marekw1986/InternetRadioSTM32/hardware/main_board.brd

## EAGLE design hardware/main_board.brd (2020-12-28)

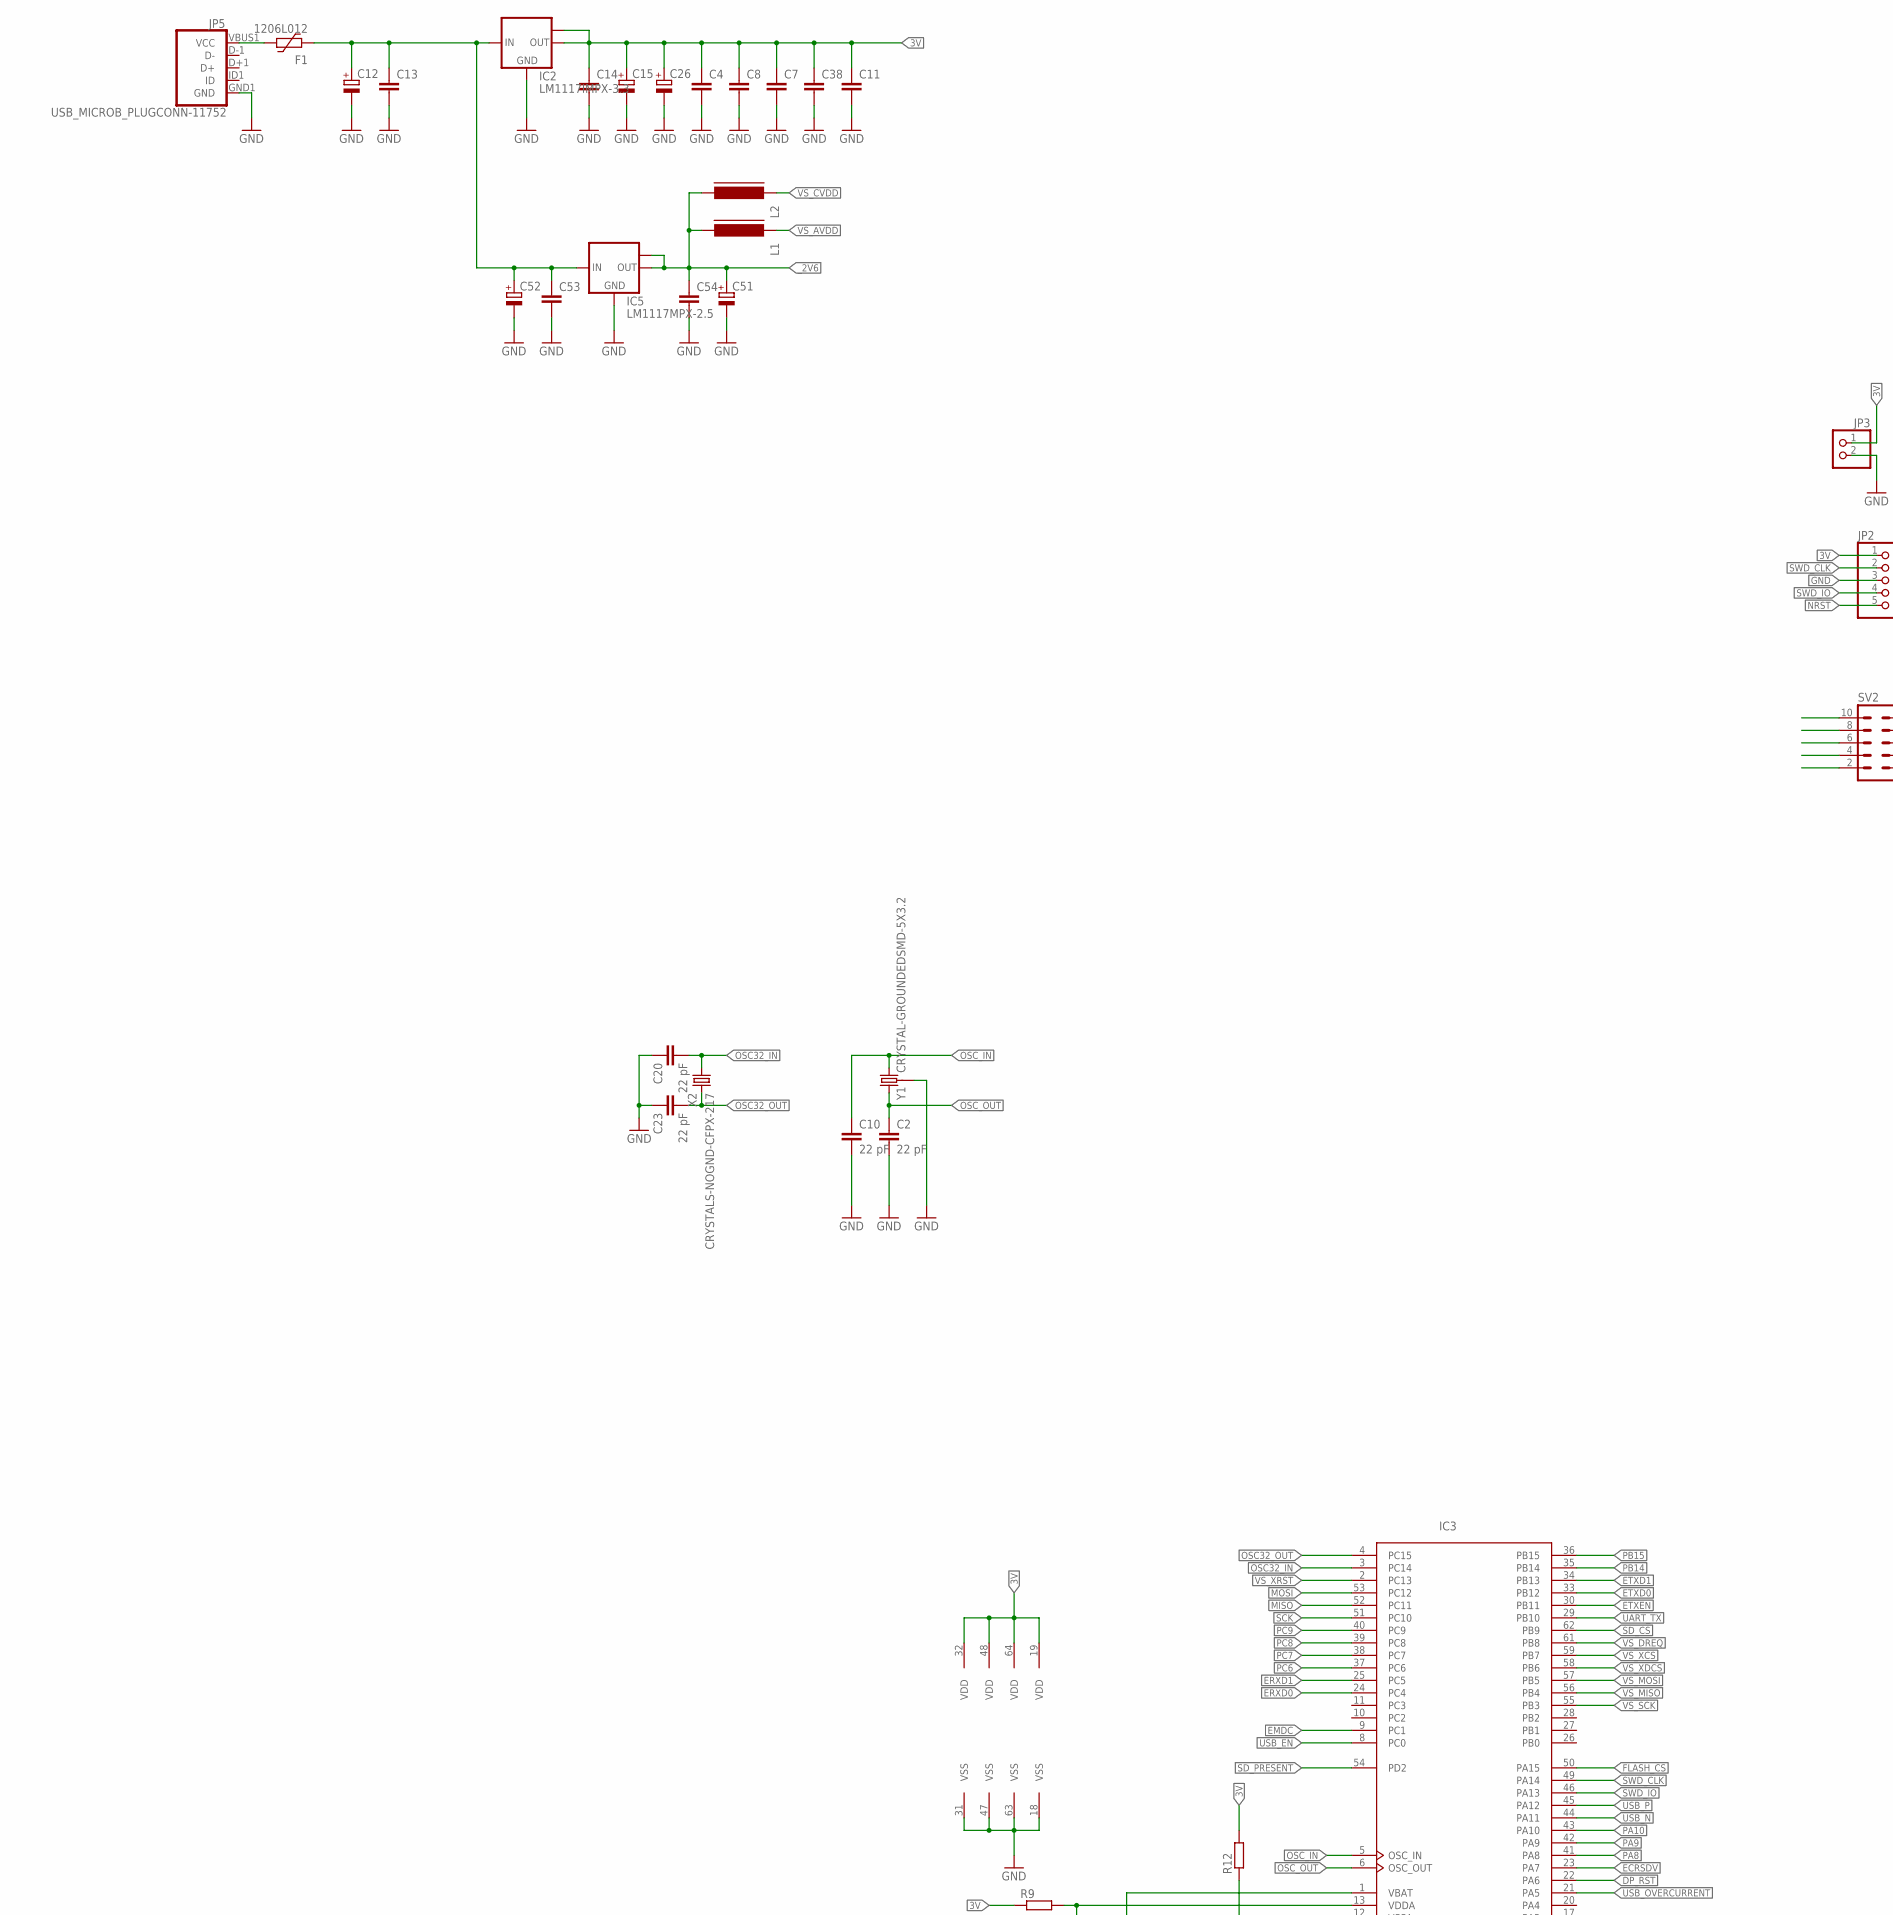
[picture p1: schematic main_board.sch, part in row 1, column 1]

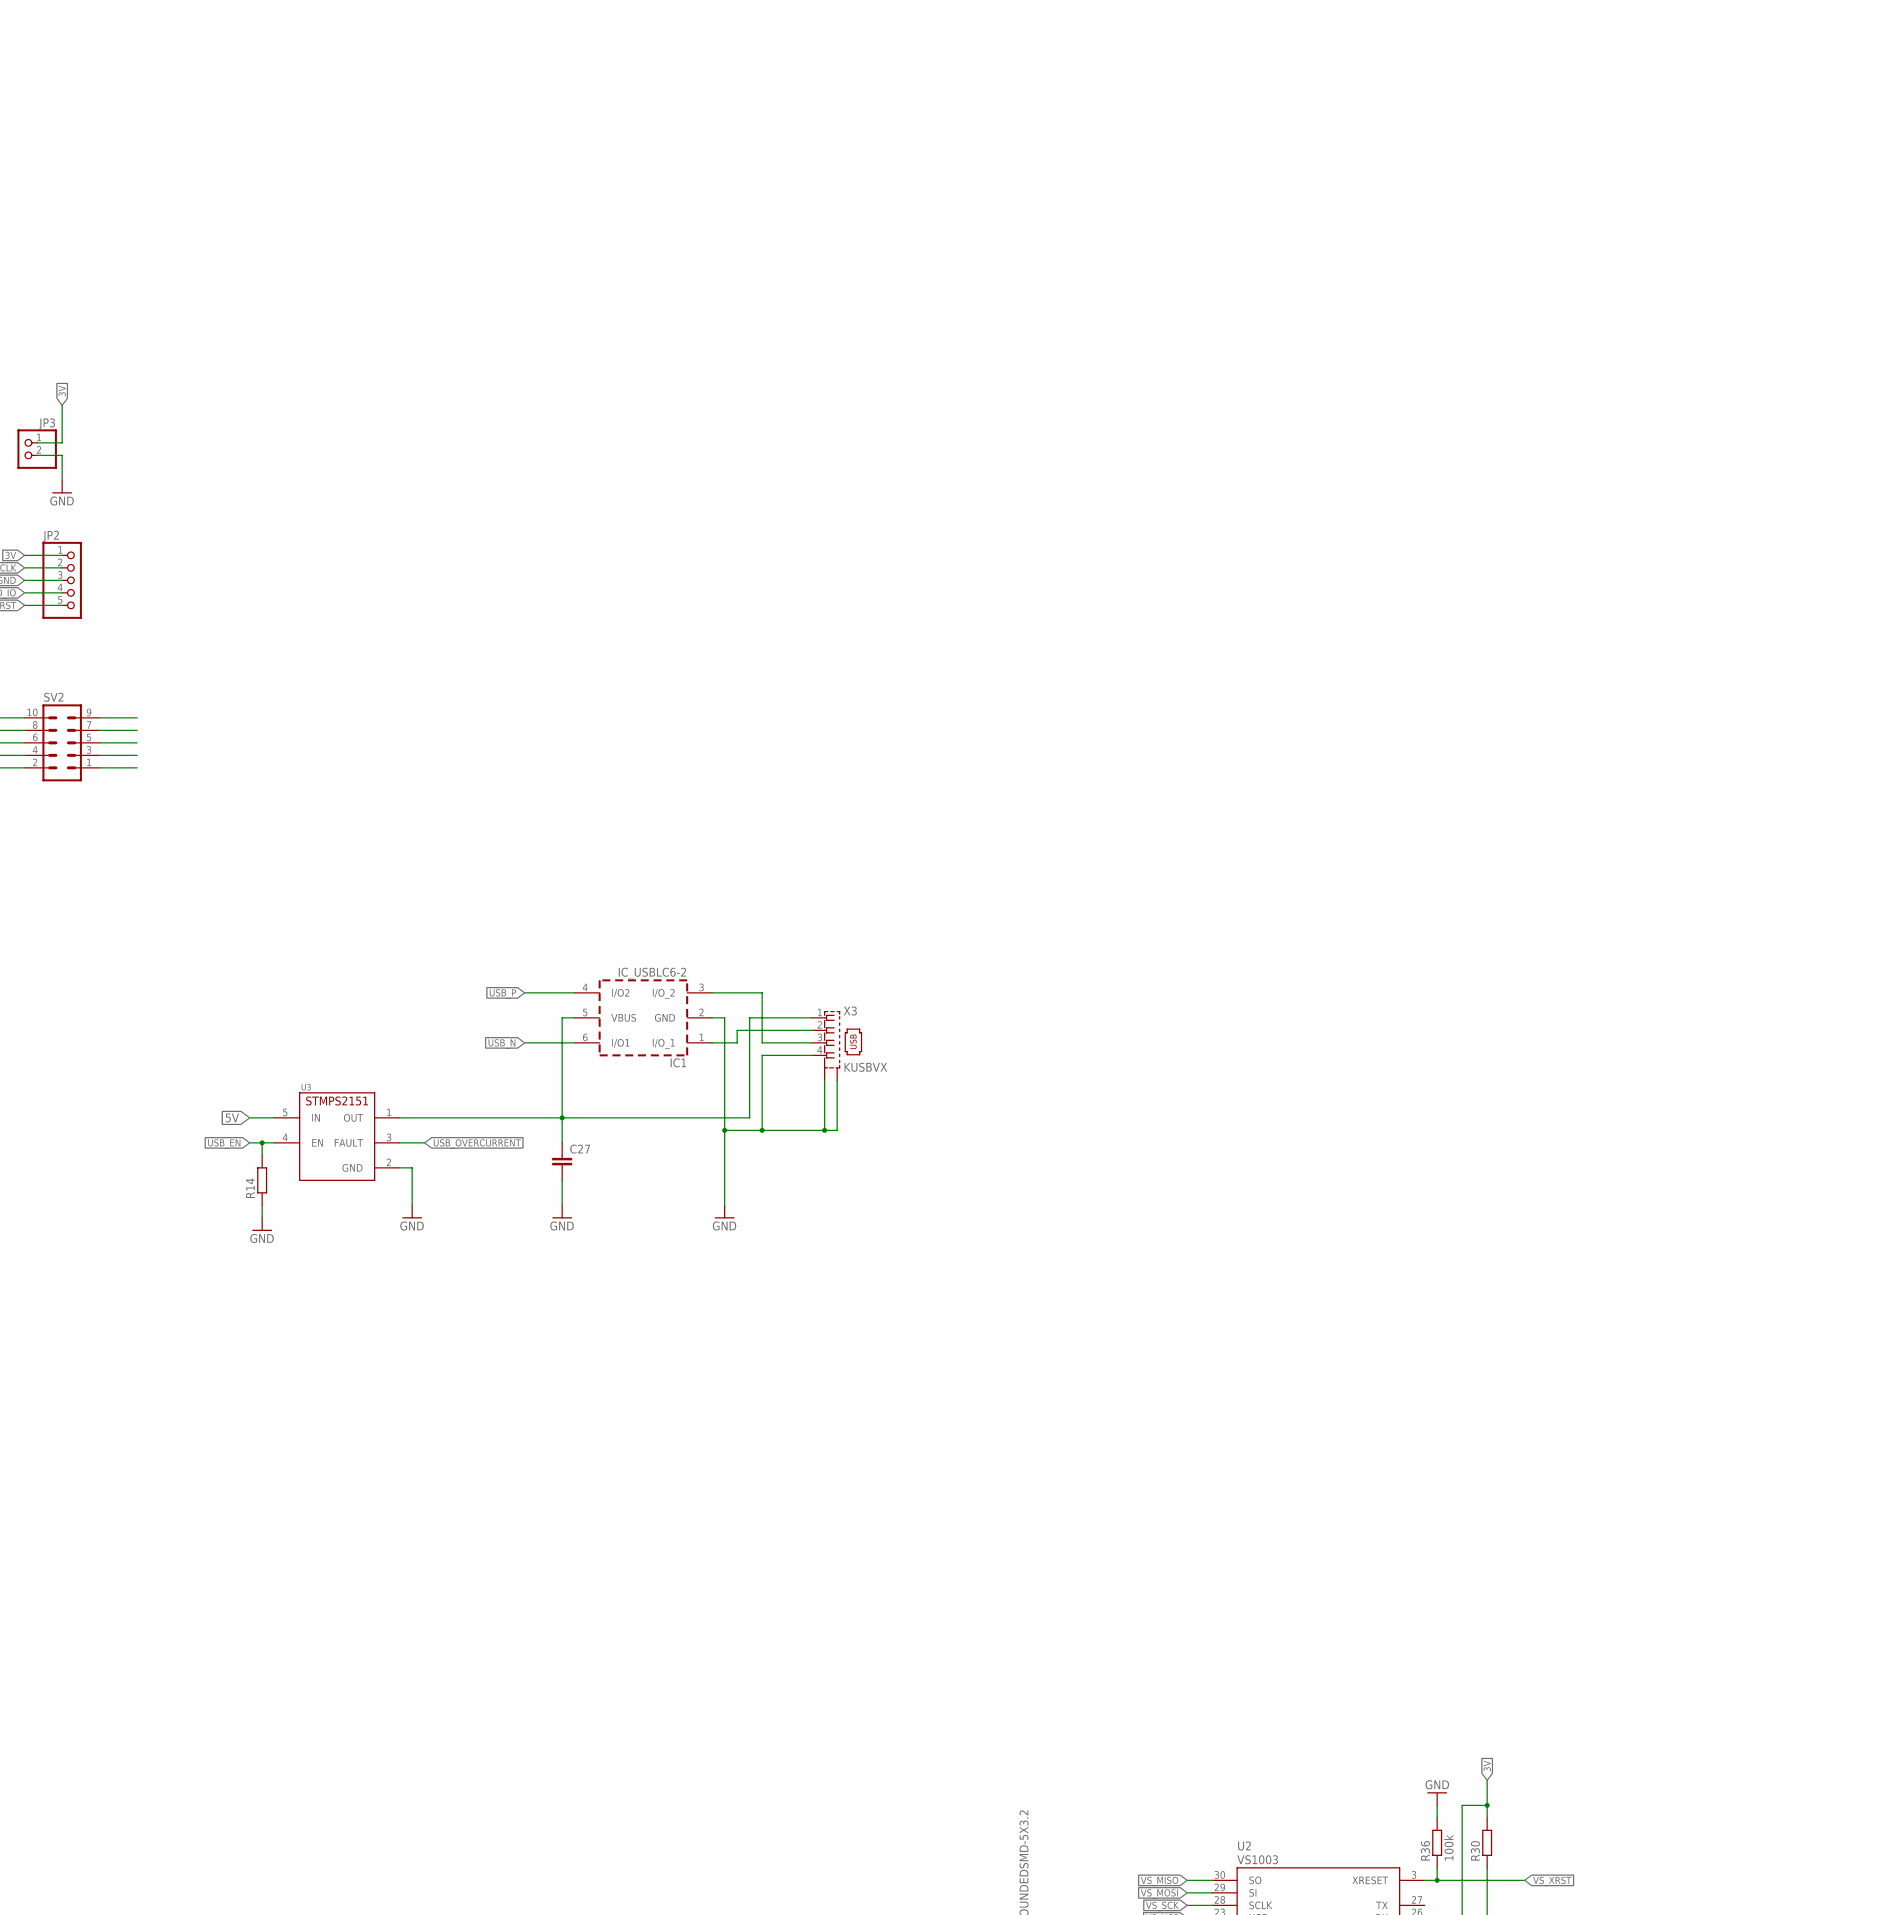
[picture p2: schematic main_board.sch, part in row 1, column 2]

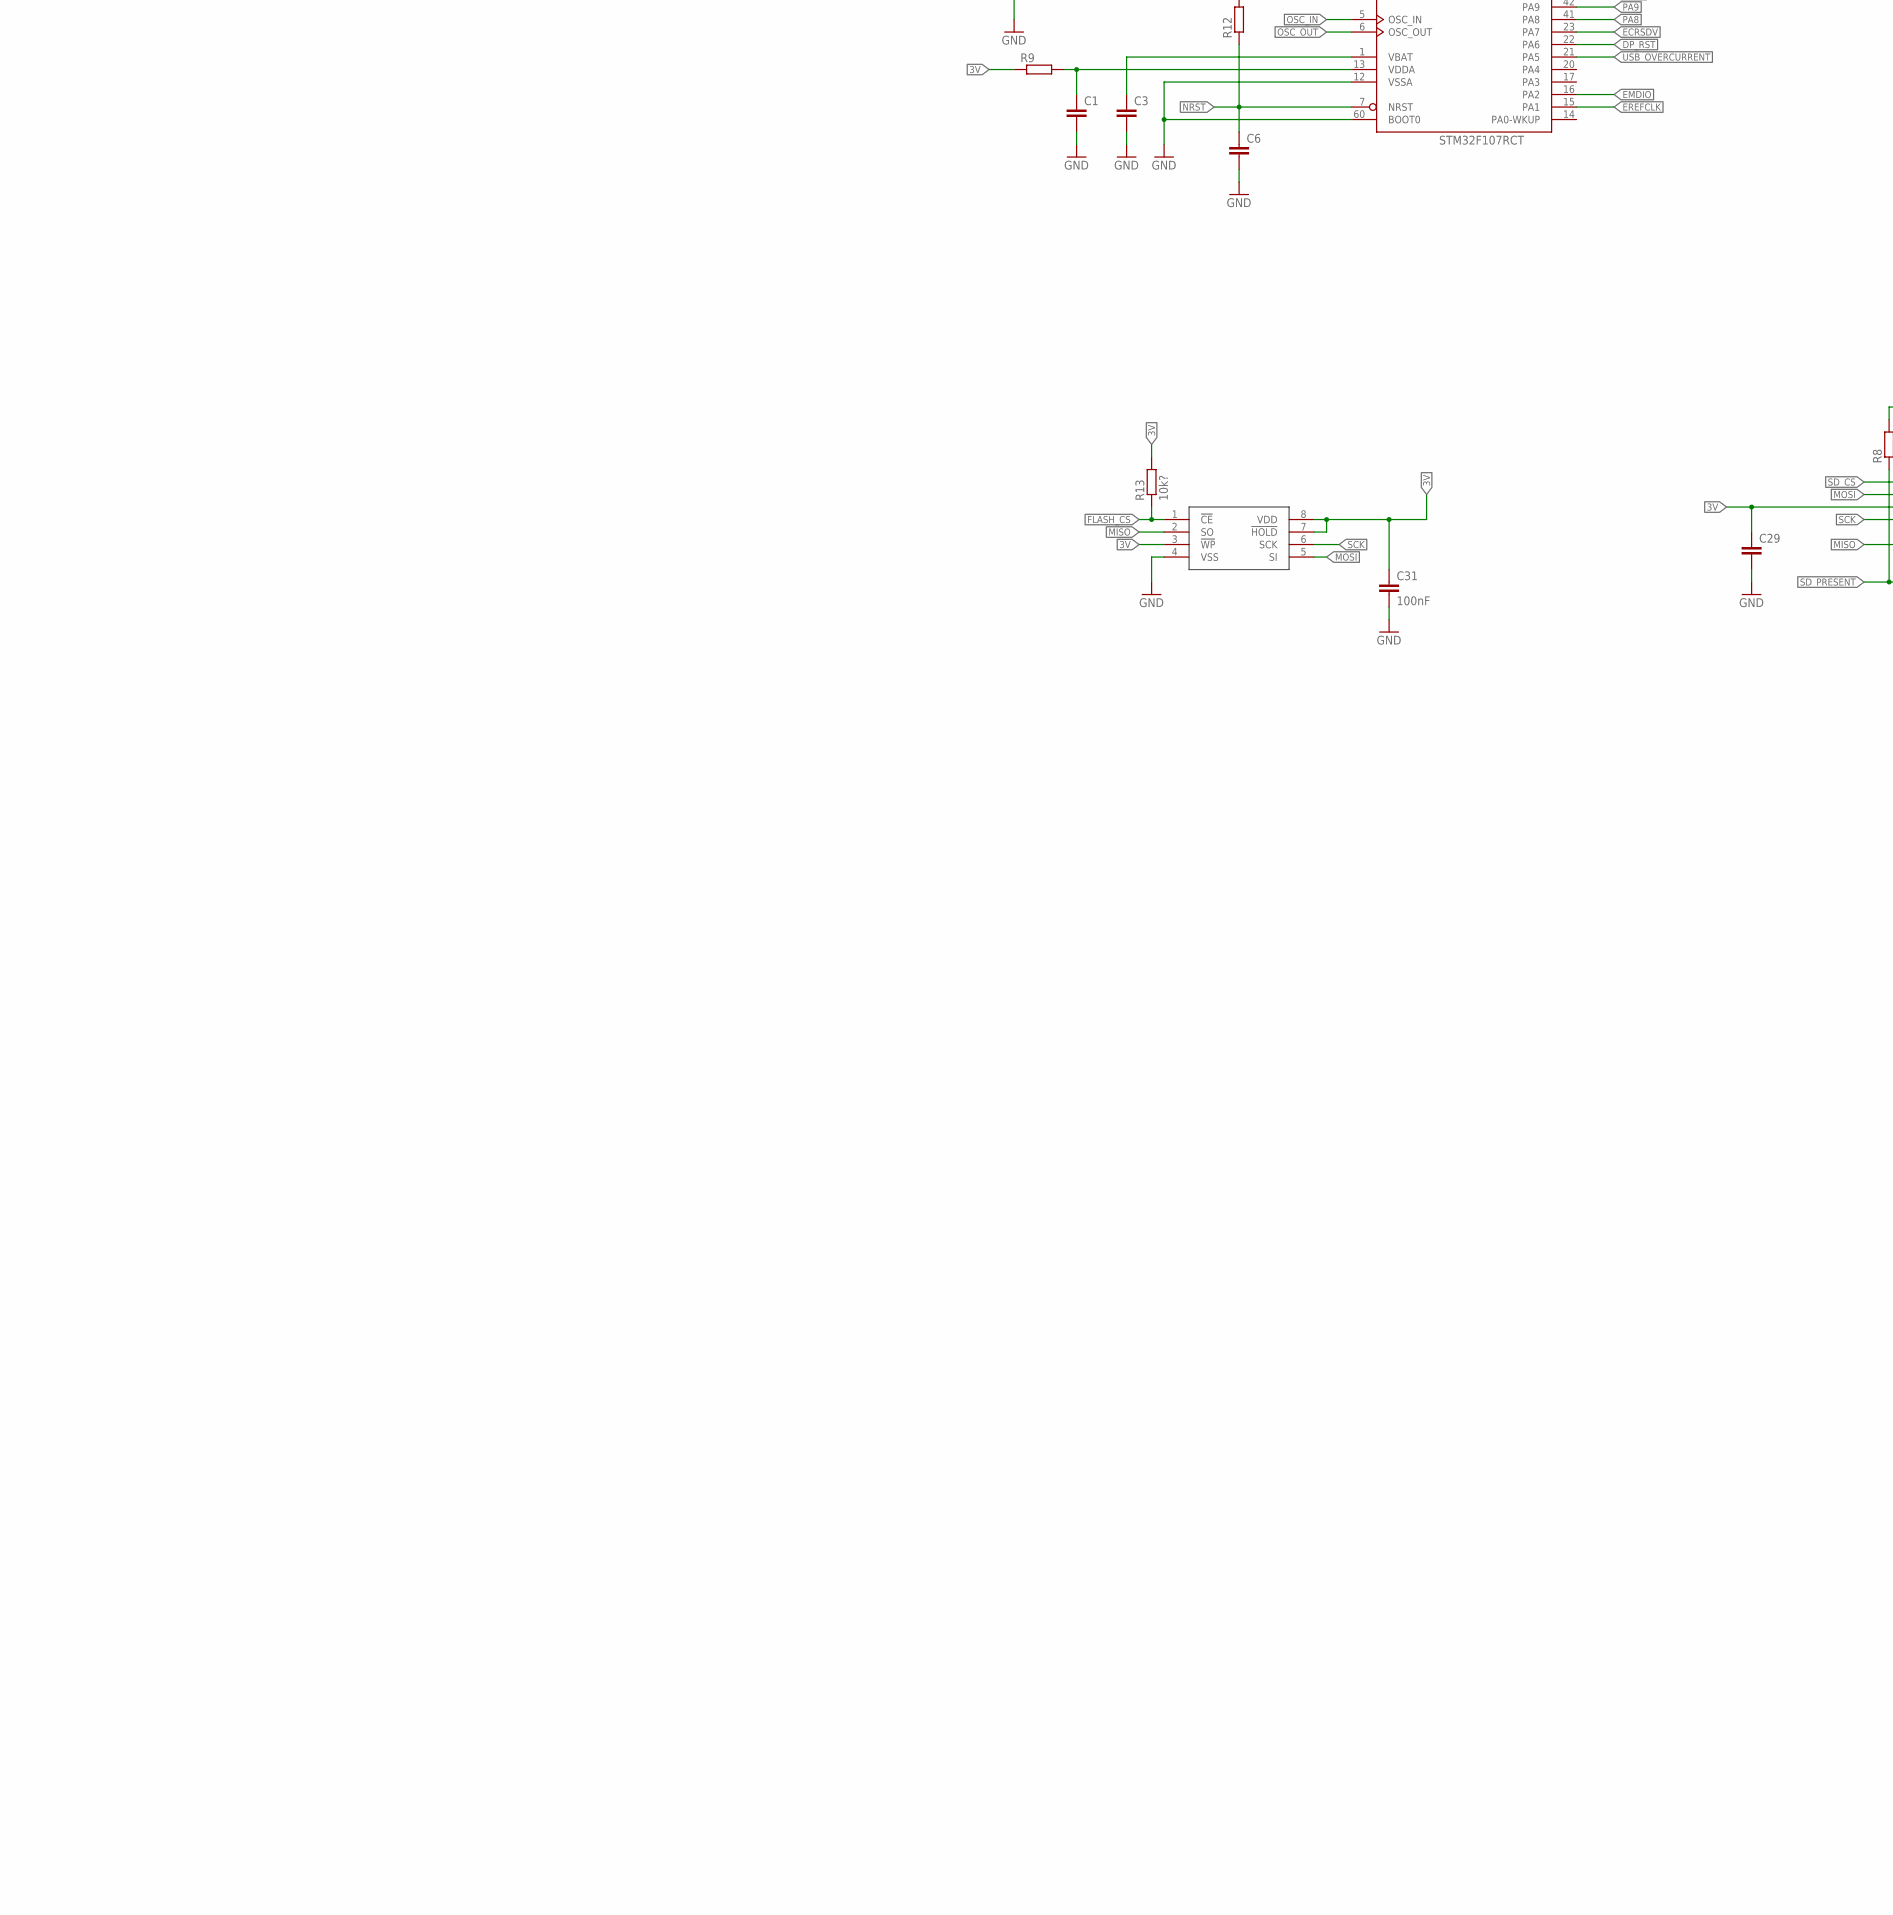
[picture p3: schematic main_board.sch, part in row 2, column 1]

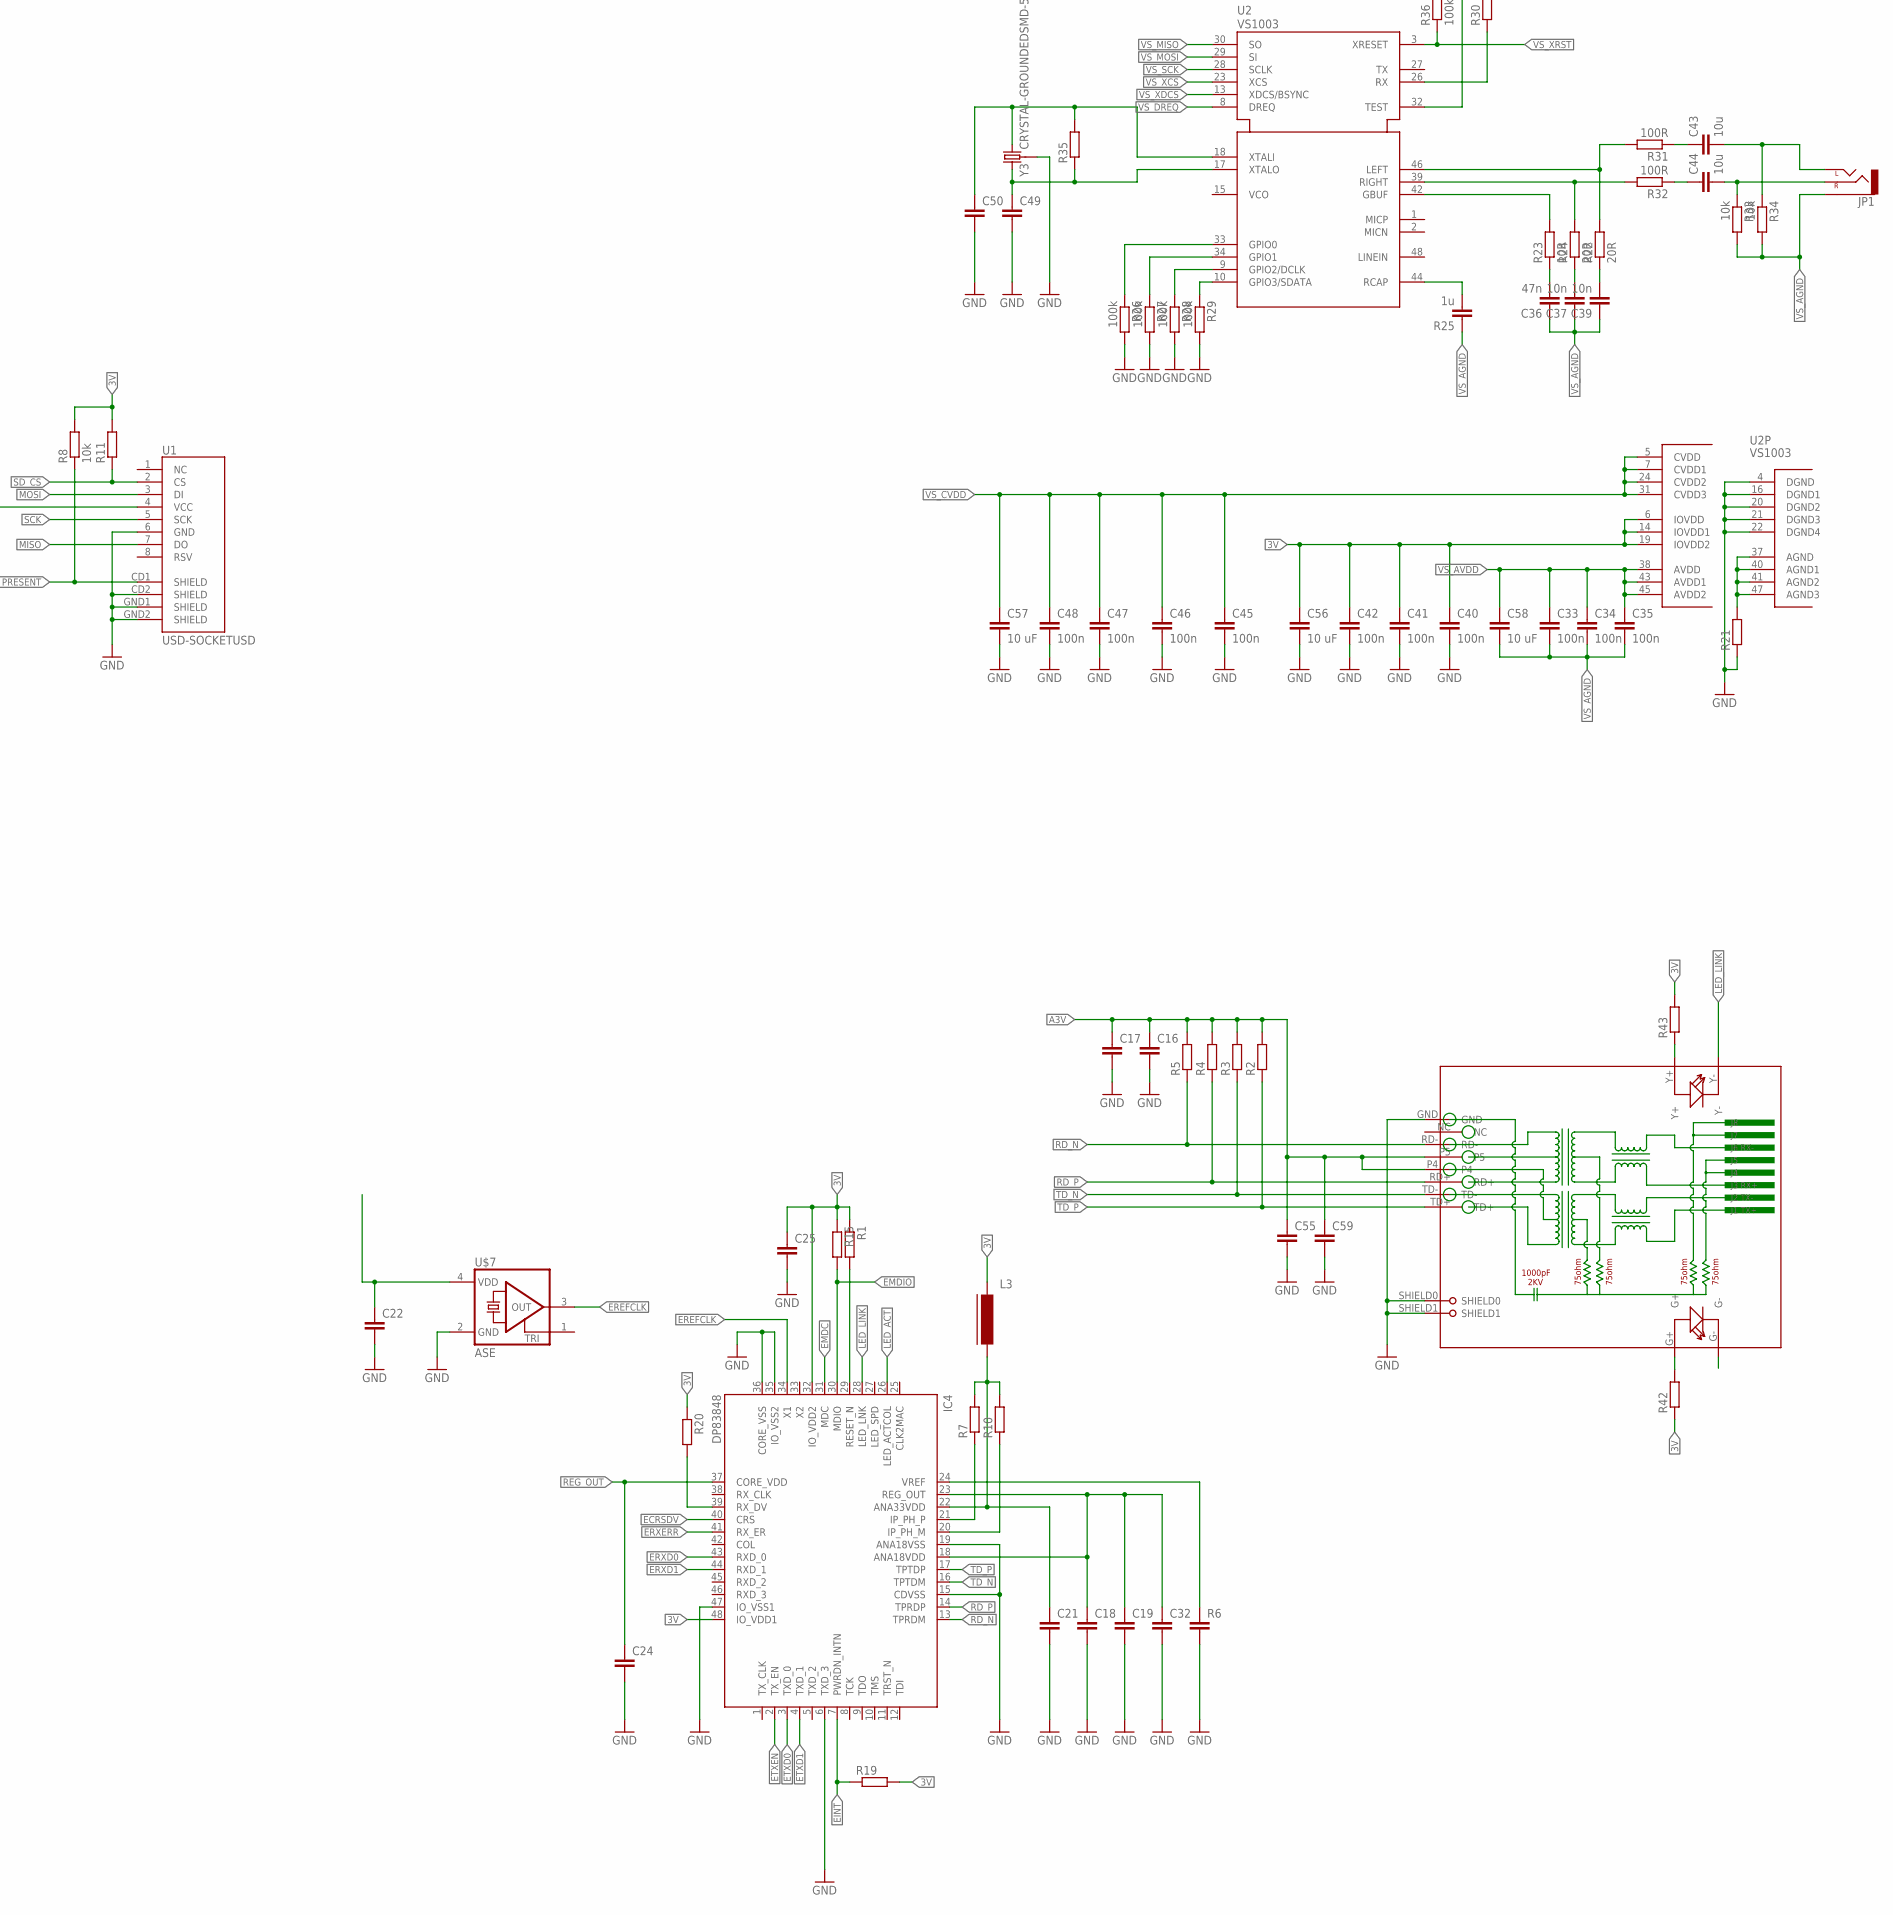
[picture p4: schematic main_board.sch, part in row 2, column 2]

Parts:
C1, C3, C4, C7, C8, C11, C18, C19, C21, C22, C38: C-EUC0402; C0402
C2, C10, C20, C23: 22 pF; C0603
C6, C13, C14, C16, C17, C24, C25, C27, C29, C32, C49, C50, C55, C59: C-EUC0603; C0603
C12, C15, C51, C52: CPOL-EUSMCB; SMC_B
C26: CPOL-EUSMCA; SMC_A
C31: 100nF; C0603
C33, C34, C35, C46, C47, C48: 100n; C0603
C36: 47n; C0603
C37, C39: 10n; C0603
C40, C41, C42, C45: 100n; C0402
C43, C44: 10u; C0603
C53, C54: C-EUC1206; C1206
C56, C57, C58: 10 uF; C0603
F1: 1206L012; 1206L
IC1: IC_USBLC6-2; SOT-23-6L
IC2: LM1117IMPX-3.3; SOT223
IC3: STM32F107RCT; LQFP64
IC4: DP83848; LQFP48
IC5: LM1117MPX-2.5; SOT223
JP1: AUDIO-JACKAUDIO_JACK2; AUDIO-JACK2
JP2: PINHD-1X5; 1X05
JP3: PINHD-1X2/90; 1X02/90
JP5: USB_MICROB_PLUGCONN-11752; USB-B-MICRO-SMD_V03
L1, L2, L3: FERRITE-0805; FB805
R1, R7, R10, R19: R-EU_R0402; R0402
R2, R3, R4, R5, R11, R12, R14, R15, R20, R21, R35, R42, R43: R-EU_R0603; R0603
R6: C-EUC0603; C0603
R8, R33, R34: 10k; R0603
R9: R-EU_M0805; M0805
R13: 10k?; R0603
R22, R24: 20R; R0603
R23: 10R; R0603
R25: 1u; C0603
R26, R27, R28, R29: 100k; R0402
R30: R-EU_0204/7; 0204/7
R31, R32: 100R; R0603
R36: 100k; R0603
RJ1: HR911105A
SV2: ML10L
U1: USD-SOCKETUSD; USD-SOCKET-PP
U2: VS1003; LQFP48
U3: STMPS2151STR; SOT-23-5L
U$2: SST25VF016BSO8M; SO-08M
U$7: ASE
X2: CRYSTALS-NOGND-CFPX-217; 3.2X1.5-2-PAD
X3: KUSBVX
Y1, Y3: CRYSTAL-GROUNDEDSMD-5X3.2; CRYSTAL-SMD-5X3.2-4PAD

Connections:
3V: C4.1, C7.1, C8.1, C11.1, C14.1, C15.+, C22.1, C25.1, C26.+, C29.1, C31.1, C38.1, C40.1, C41.1, C42.1, C56.1, IC2.2 (OUT), IC2.TAB (OUT1), IC3.19 (VDD), IC3.32 (VDD), IC3.48 (VDD), IC3.64 (VDD), IC4.32 (IO_VDD2), IC4.48 (IO_VDD1), JP2.1, JP3.1, L3.1, R1.1, R8.2, R9.1, R11.2, R12.2, R13.2, R15.1, R19.2, R20.1, R30.2, R42.1, R43.2, U1.4 (VCC), U2.6 (IOVDD), U2.14 (IOVDD1), U2.19 (IOVDD2), U2.32 (TEST), U$2.3 (!WP), U$2.7 (!HOLD), U$2.8 (VDD), U$7.4 (VDD)
5V: C12.+, C13.1, C52.+, C53.1, F1.2, IC2.3 (IN), IC5.3 (IN), U3.5 (IN)
A3V: C16.1, C17.1, C21.1, C55.1, C59.1, IC4.22 (ANA33VDD), L3.2, R2.2, R3.2, R4.2, R5.2, R7.2, R10.2, RJ1.P4, RJ1.P5
D2_N: IC1.1 (I/O_1), X3.2
D2_P: IC1.3 (I/O_2), X3.3
DP_RST: IC3.22 (PA6), IC4.29 (RESET_N), R1.2
ECRSDV: IC3.23 (PA7), IC4.40 (CRS)
EINT: IC4.7 (PWRDN_INTN), R19.1
EMDC: IC3.9 (PC1), IC4.31 (MDC)
EMDIO: IC3.16 (PA2), IC4.30 (MDIO), R15.2
EREFCLK: IC3.15 (PA1), IC4.34 (X1), U$7.3 (OUT)
ERXD0: IC3.24 (PC4), IC4.43 (RXD_0)
ERXD1: IC3.25 (PC5), IC4.44 (RXD_1)
ERXERR: IC4.41 (RX_ER)
ETXD0: IC3.33 (PB12), IC4.3 (TXD_0)
ETXD1: IC3.34 (PB13), IC4.4 (TXD_1)
ETXEN: IC3.30 (PB11), IC4.2 (TX_EN)
FLASH_CS: IC3.50 (PA15), R13.1, U$2.1 (!CE)
GND: C1.2, C2.2, C3.2, C4.2, C6.2, C7.2, C8.2, C10.2, C11.2, C12.-, C13.2, C14.2, C15.-, C16.2, C17.2, C18.2, C19.2, C20.1, C21.2, C22.2, C23.1, C24.2, C25.2, C26.-, C27.2, C29.2, C31.2, C32.2, C38.2, C40.2, C41.2, C42.2, C45.2, C46.2, C47.2, C48.2, C49.2, C50.2, C51.-, C52.-, C53.2, C54.2, C55.2, C56.2, C57.2, C59.2, IC1.2 (GND), IC2.1 (GND), IC3.12 (VSSA), IC3.18 (VSS), IC3.31 (VSS), IC3.47 (VSS), IC3.60 (BOOT0), IC3.63 (VSS), IC4.6 (TXD_3), IC4.15 (CDVSS), IC4.19 (ANA18VSS), IC4.35 (IO_VSS2), IC4.36 (CORE_VSS), IC4.47 (IO_VSS1), IC5.1 (GND), JP2.3, JP3.2, JP5.GND1 (GND), R6.2, R14.1, R21.1, R26.2, R27.2, R28.2, R29.2, R36.2, RJ1.GND, RJ1.SHIELD0, RJ1.SHIELD1, U1.6 (GND), U1.CD2 (SHIELD), U1.GND1 (SHIELD), U1.GND2 (SHIELD), U2.4 (DGND), U2.16 (DGND1), U2.20 (DGND2), U2.21 (DGND3), U2.22 (DGND4), U3.2 (GND), U$2.4 (VSS), U$7.2 (GND), X3.4, X3.M1 (S1), X3.M2 (S2), Y1.2 (3), Y1.4 (3), Y3.2 (3), Y3.4 (3)
LED_ACT: IC4.26 (LED_ACTCOL), RJ1.G-
LED_LINK: IC4.28 (LED_LNK), RJ1.Y-
MISO: IC3.52 (PC11), U1.7 (DO), U$2.2 (SO)
MOSI: IC3.53 (PC12), U1.3 (DI), U$2.5 (SI)
unnamed: IC4.21 (IP_PH_P), R7.1
unnamed: C3.1, IC3.1 (VBAT)
unnamed: IC4.24 (VREF), R6.1
unnamed: IC4.20 (IP_PH_M), R10.1
unnamed: R42.2, RJ1.G+
unnamed: F1.1, JP5.VBUS1 (VCC)
unnamed: C36.2, R23.1
unnamed: R43.1, RJ1.Y+
unnamed: C1.1, IC3.13 (VDDA), R9.2
NRST: C6.1, IC3.7 (NRST), JP2.5, R12.1
OSC32_IN: C20.2, IC3.3 (PC14), X2.1
OSC32_OUT: C23.2, IC3.4 (PC15), X2.2
OSC_IN: C10.1, IC3.5 (OSC_IN), Y1.1 (2)
OSC_OUT: C2.1, IC3.6 (OSC_OUT), Y1.3 (1)
PA8: IC3.41 (PA8), SV2.8
PA9: IC3.42 (PA9), SV2.9
PA10: IC3.43 (PA10), SV2.10
PB14: IC3.35 (PB14), SV2.2
PB15: IC3.36 (PB15), SV2.3
PC6: IC3.37 (PC6), SV2.4
PC7: IC3.38 (PC7), SV2.5
PC8: IC3.39 (PC8), SV2.6
PC9: IC3.40 (PC9), SV2.7
RD_N: IC4.13 (TPRDM), R5.1, RJ1.RD-
RD_P: IC4.14 (TPRDP), R4.1, RJ1.RD+
REG_OUT: C18.1, C19.1, C24.1, C32.1, IC4.18 (ANA18VDD), IC4.23 (REG_OUT), IC4.37 (CORE_VDD)
RX_DV: IC4.39 (RX_DV), R20.2
SCK: IC3.51 (PC10), U1.5 (SCK), U$2.6 (SCK)
SD_CS: IC3.62 (PB9), R11.1, U1.2 (CS)
SD_PRESENT: IC3.54 (PD2), R8.1, U1.CD1 (SHIELD)
SWD_CLK: IC3.49 (PA14), JP2.2
SWD_IO: IC3.46 (PA13), JP2.4
TD_N: IC4.16 (TPTDM), R3.1, RJ1.TD-
TD_P: IC4.17 (TPTDP), R2.1, RJ1.TD+
UART_TX: IC3.29 (PB10), SV2.1
USB_EN: IC3.8 (PC0), R14.2, U3.4 (EN)
USB_N: IC1.6 (I/O1), IC3.44 (PA11)
USB_OVERCURRENT: IC3.21 (PA5), U3.3 (FAULT)
USB_P: IC1.4 (I/O2), IC3.45 (PA12)
VBUS: C27.1, IC1.5 (VBUS), U3.1 (OUT), X3.1
VS_AGND: C33.2, C34.2, C35.2, C36.1, C37.1, C39.1, C58.2, JP1.SLEEVE, R21.2, R25.1, R33.2, R34.2, U2.37 (AGND), U2.40 (AGND1), U2.41 (AGND2), U2.47 (AGND3)
VS_AVDD: C33.1, C34.1, C35.1, C58.1, L1.1, U2.38 (AVDD), U2.43 (AVDD1), U2.45 (AVDD2)
VS_CVDD: C45.1, C46.1, C47.1, C48.1, C57.1, L2.1, U2.5 (CVDD), U2.7 (CVDD1), U2.24 (CVDD2), U2.31 (CVDD3)
VS_DREQ: IC3.61 (PB8), U2.8 (DREQ)
VS_MISO: IC3.56 (PB4), U2.30 (SO)
VS_MOSI: IC3.57 (PB5), U2.29 (SI)
VS_N$9: C50.1, R35.2, U2.18 (XTALI), Y3.1 (2)
VS_N$13: C49.1, R35.1, U2.17 (XTALO), Y3.3 (1)
VS_N$14: R22.2, R31.2, U2.46 (LEFT)
VS_N$15: R23.2, U2.42 (GBUF)
VS_N$16: R24.2, R32.2, U2.39 (RIGHT)
VS_N$17: R25.2, U2.44 (RCAP)
VS_N$24: C37.2, R24.1
VS_N$25: C39.2, R22.1
VS_N$26: R29.1, U2.10 (GPIO3/SDATA)
VS_N$27: R28.1, U2.9 (GPIO2/DCLK)
VS_N$28: R27.1, U2.34 (GPIO1)
VS_N$30: R26.1, U2.33 (GPIO0)
VS_N$34: R30.1, U2.26 (RX)
VS_N$35: C43.1, R31.1
VS_N$36: C44.1, R32.1
VS_N$37: C44.2, JP1.RING (RIGHT), R33.1
VS_N$38: C43.2, JP1.TIP (LEFT), R34.1
VS_SCK: IC3.55 (PB3), U2.28 (SCLK)
VS_XCS: IC3.59 (PB7), U2.23 (XCS)
VS_XDCS: IC3.58 (PB6), U2.13 (XDCS/BSYNC)
VS_XRST: IC3.2 (PC13), R36.1, U2.3 (XRESET)
_2V6: C51.+, C54.1, IC5.2 (OUT), IC5.TAB (OUT1), L1.2, L2.2

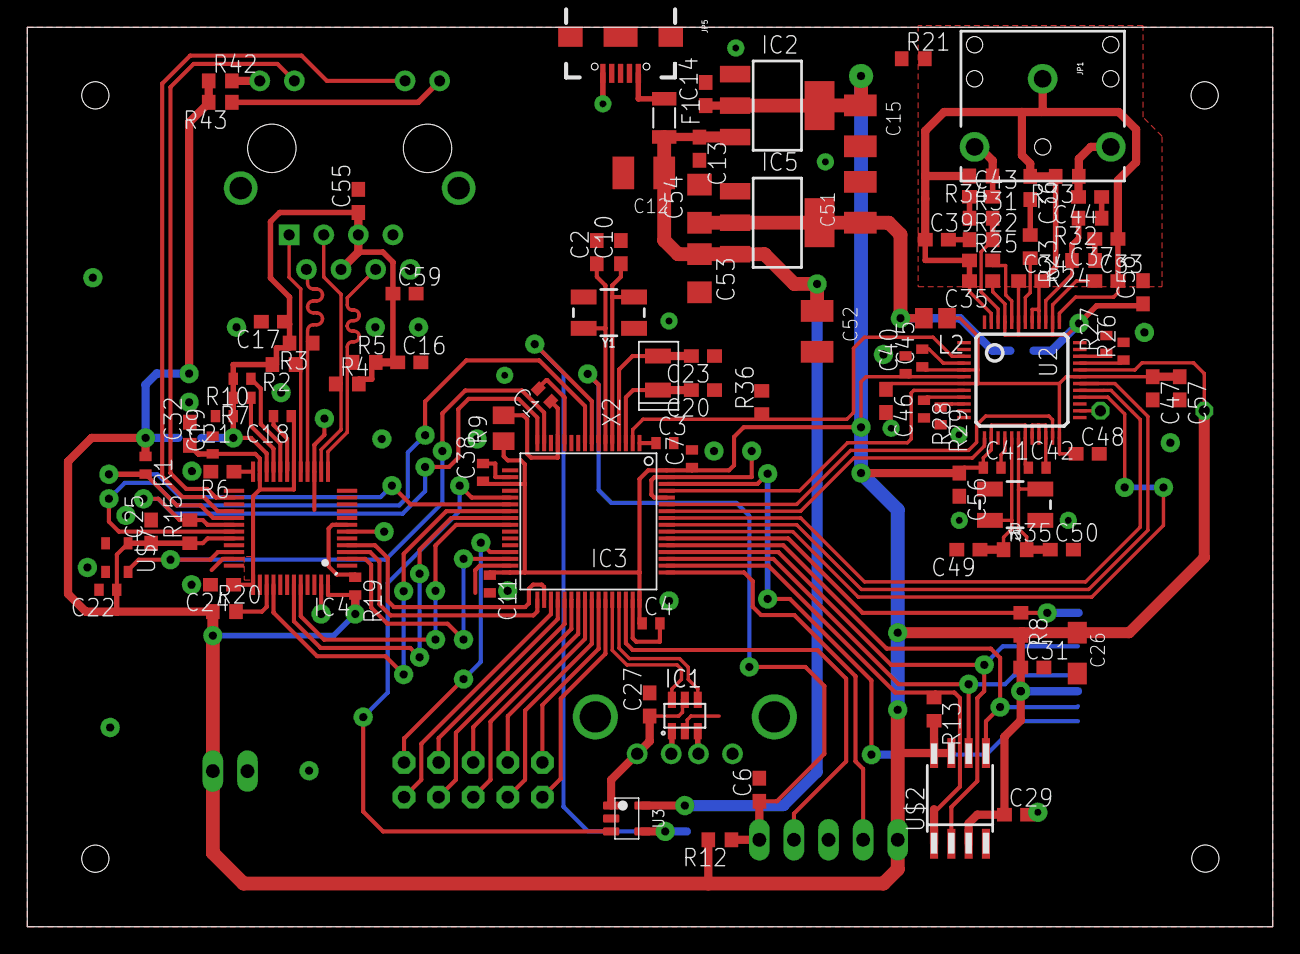
[picture p5: board main_board.brd from above]

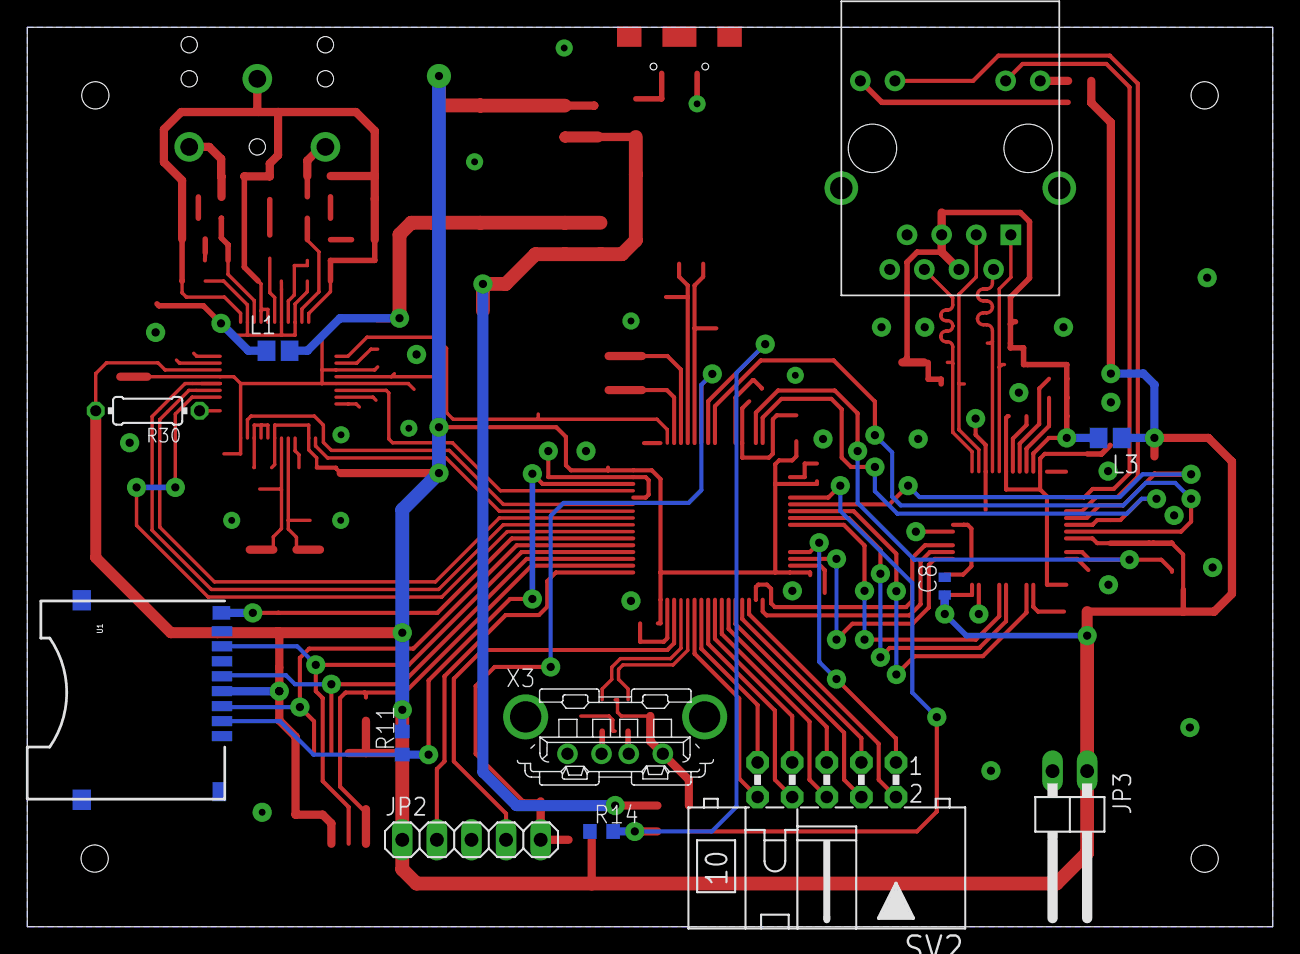
[picture p6: board main_board.brd from below]

Board: 2 copper layers, 91.4 x 66.0 mm, 114 parts (12 on the bottom side), 90 nets.
