marekw1986/InternetRadioSTM32/code/Core/Src/main.c

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
/* Includes ------------------------------------------------------------------*/
#include "main.h"
#include "cmsis_os.h"
#include "fatfs.h"
#include "lwip.h"
#include "usb_host.h"

/* USER CODE BEGIN Includes */
#include <stdio.h>
#include <stdint.h>
#include <errno.h>
#include <time.h>
#include <sys/unistd.h> // STDOUT_FILENO, STDERR_FILENO
#include "tm.h"
#include "common.h"
#include "vs1003.h"
#include "user_diskio.h"
#include "sd.h"
#include "spiram.h"
#include "buttons.h"
#include "lwip/apps/lwiperf.h"
#include "lwip/apps/sntp.h"
/* USER CODE END Includes */

CRC_HandleTypeDef hcrc;

RTC_HandleTypeDef hrtc;

SPI_HandleTypeDef hspi1;
SPI_HandleTypeDef hspi3;

TIM_HandleTypeDef htim4;

UART_HandleTypeDef huart1;

osThreadId mainTaskHandle;
osThreadId ioTaskHandle;
osMessageQId vsQueueHandle;
/* USER CODE BEGIN PV */
FATFS FatFS;
/* USER CODE END PV */

void SystemClock_Config(void);
static void MX_GPIO_Init(void);
static void MX_USART1_UART_Init(void);
static void MX_SPI3_Init(void);
static void MX_RTC_Init(void);
static void MX_SPI1_Init(void);
static void MX_TIM4_Init(void);
static void MX_CRC_Init(void);
void StartMainTask(void const * argument);
void StartIoTask(void const * argument);

/* USER CODE BEGIN PFP */
void usb_write (void);
void set_rtc_with_ntp_timstamp(uint32_t sec);
void next_callback(void);
/* USER CODE END PFP */

/**
  * @brief  The application entry point.
  * @retval int
  */
int main(void)
{

  /* USER CODE BEGIN 1 */
  //uint8_t buffer[64];
  /* USER CODE END 1 */

  /* MCU Configuration--------------------------------------------------------*/

  /* Reset of all peripherals, Initializes the Flash interface and the Systick. */
  HAL_Init();

  /* Configure the system clock */
  SystemClock_Config();

  /* Initialize all configured peripherals */
  MX_GPIO_Init();
  MX_USART1_UART_Init();
  MX_FATFS_Init();
  MX_SPI3_Init();
  MX_RTC_Init();
  MX_SPI1_Init();
  MX_TIM4_Init();
  MX_CRC_Init();
  /* USER CODE BEGIN 2 */
  HAL_TIM_Base_Start(&htim4);									//Required for delay_us
  /* USER CODE END 2 */

  /* USER CODE BEGIN RTOS_MUTEX */
  /* add mutexes, ... */
  /* USER CODE END RTOS_MUTEX */

  /* USER CODE BEGIN RTOS_SEMAPHORES */
  /* add semaphores, ... */
  /* USER CODE END RTOS_SEMAPHORES */

  /* USER CODE BEGIN RTOS_TIMERS */
  /* start timers, add new ones, ... */
  /* USER CODE END RTOS_TIMERS */

  /* Create the queue(s) */
  /* definition and creation of vsQueue */
  osMessageQDef(vsQueue, 16, uint8_t);
  vsQueueHandle = osMessageCreate(osMessageQ(vsQueue), NULL);

  /* USER CODE BEGIN RTOS_QUEUES */
  /* add queues, ... */
  /* USER CODE END RTOS_QUEUES */

  /* Create the thread(s) */
  /* definition and creation of mainTask */
  osThreadDef(mainTask, StartMainTask, osPriorityNormal, 0, 512);
  mainTaskHandle = osThreadCreate(osThread(mainTask), NULL);

  /* definition and creation of ioTask */
  osThreadDef(ioTask, StartIoTask, osPriorityIdle, 0, 256);
  ioTaskHandle = osThreadCreate(osThread(ioTask), NULL);

  /* USER CODE BEGIN RTOS_THREADS */
  /* add threads, ... */
  /* USER CODE END RTOS_THREADS */

  /* Start scheduler */
  osKernelStart();

  /* We should never get here as control is now taken by the scheduler */

  /* Infinite loop */
  /* USER CODE BEGIN WHILE */
  while (1)
  {
    /* USER CODE END WHILE */

    /* USER CODE BEGIN 3 */
  }
  /* USER CODE END 3 */
}

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
/* USER CODE BEGIN 4 */
int _write(int file, char *data, int len)
{
   if ((file != STDOUT_FILENO) && (file != STDERR_FILENO))
   {
      errno = EBADF;
      return -1;
   }

   HAL_StatusTypeDef status = HAL_UART_Transmit(&huart1, (uint8_t*)data, len, 1000);

   // return # of bytes written - as best we can tell
   return (status == HAL_OK ? len : 0);
}

void usb_write (void) {
    FRESULT res;
    FIL file;

    res = f_open(&file, "1:/test.txt", (FA_OPEN_ALWAYS | FA_WRITE));
    if (res != FR_OK) {
        printf("f_open error code: %i\r\n", res);
        return;
    }
    if (f_size(&file) == 0) {
        f_puts("To jest pierwsza linia\r\n", &file);
    }
    else {
        res = f_lseek(&file, f_size(&file));
        if (res != FR_OK) {
            printf("f_lseek error code: %i\r\n", res);
            f_close(&file);
            return;
        }
    }
    f_puts("To jest test.\n", &file);
    f_close(&file);
}

void set_rtc_with_ntp_timstamp(uint32_t sec) {
	RTC_TimeTypeDef sTime;
	RTC_DateTypeDef sDate;
	struct tm time_tm;
	time_t rawtime = sec;

	printf("NTP timestamp received: %lu\r\n", sec);
	gmtime_r(&rawtime, &time_tm);

	sTime.Hours = (uint8_t)time_tm.tm_hour;
	sTime.Minutes = (uint8_t)time_tm.tm_min;
	sTime.Seconds = (uint8_t)time_tm.tm_sec;
	if (HAL_RTC_SetTime(&hrtc, &sTime, RTC_FORMAT_BIN) != HAL_OK) {
		printf("Can't set time\r\n");
	}
	if (time_tm.tm_wday == 0) { time_tm.tm_wday = 7; }
	sDate.WeekDay = (uint8_t)time_tm.tm_wday;
	sDate.Month = (uint8_t)time_tm.tm_mon+1;
	sDate.Date = (uint8_t)time_tm.tm_mday;
	sDate.Year = (uint16_t)(time_tm.tm_year+1900-2000);
	if (HAL_RTC_SetDate(&hrtc, &sDate, RTC_FORMAT_BIN) != HAL_OK) {
		printf("Can't set date\r\n");
	}

}

void next_callback (void) {
	printf("Next button pressed\r\n");
	static uint8_t to_send = VS_MSG_NEXT;
	if (xQueueSend(vsQueueHandle, (void*)&to_send, portMAX_DELAY)) {
		printf("VS_MSG_NEXT sent to queque\r\n");
	}
}

/* USER CODE END 4 */

/* USER CODE BEGIN Header_StartMainTask */
/**
  * @brief  Function implementing the mainTask thread.
  * @param  argument: Not used
  * @retval None
  */
/* USER CODE END Header_StartMainTask */
void StartMainTask(void const * argument)
{
  /* init code for LWIP */
  MX_LWIP_Init();

  /* init code for USB_HOST */
  MX_USB_HOST_Init();
  /* USER CODE BEGIN 5 */
  static FRESULT res;
  uint8_t queque_rcv;

  printf("Starting default task\r\n");

  HAL_GPIO_WritePin(SPIRAM_CS_GPIO_Port, SPIRAM_CS_Pin, 1);
  HAL_GPIO_WritePin(SD_CS_GPIO_Port, SD_CS_Pin, 1);
  HAL_GPIO_WritePin(VS_XRST_GPIO_Port, VS_XRST_Pin, 0);
  HAL_GPIO_WritePin(VS_XCS_GPIO_Port, VS_XCS_Pin, 1);
  HAL_GPIO_WritePin(VS_XDCS_GPIO_Port, VS_XDCS_Pin, 1);
  HAL_GPIO_WritePin(TST_GPIO_Port, TST_Pin, 1);
  HAL_GPIO_WritePin(USB_EN_GPIO_Port, USB_EN_Pin, 1);

  res = f_mount(&FatFS, "0:", 0);
  if (res != FR_OK) {printf("f_mount error code: %i\r\n", res);}
  else {printf("f_mount OK\r\n");}

  spiram_init();
  spiram_clear();

  sntp_setoperatingmode(SNTP_OPMODE_POLL);
  sntp_setservername(0, "pool.ntp.org");
  sntp_init();

  VS1003_begin();
  VS1003_setVolume(0x00);
  VS1003_setLoop(TRUE);
//  VS1003_play_dir("0:/");
//  VS1003_play_next_http_stream_from_list();
  VS1003_play_http_stream("http://an01.cdn.eurozet.pl/ant-waw.mp3");
  /* Infinite loop */
  for(;;)
  {
	VS1003_handle();
	if (xQueueReceive(vsQueueHandle, &queque_rcv, 5) == pdTRUE) {
		printf("Received %d from queque\r\n", queque_rcv);
		switch(queque_rcv) {
			case VS_MSG_NEXT:
				VS1003_play_next();
				break;
			case VS_MSG_STOP:
				VS1003_stop();
				break;
			default:
				break;
		}
	}
	osDelay(1);
  }
  /* USER CODE END 5 */
}

/* USER CODE BEGIN Header_StartIoTask */
/**
* @brief Function implementing the ioTask thread.
* @param argument: Not used
* @retval None
*/
/* USER CODE END Header_StartIoTask */
void StartIoTask(void const * argument)
{
  /* USER CODE BEGIN StartIoTask */
  static button_t next_btn;
  RTC_TimeTypeDef RtcTime;
  RTC_DateTypeDef RtcDate;
  uint8_t compareSeconds = 0;

  printf("I/O task starting\r\n");
  button_init(&next_btn, NEXT_BTN_GPIO_Port, NEXT_BTN_Pin, next_callback, NULL);
  /* Infinite loop */
  for(;;)
  {
	button_handle(&next_btn);

	HAL_RTC_GetTime(&hrtc, &RtcTime, RTC_FORMAT_BIN);
	HAL_RTC_GetDate(&hrtc, &RtcDate, RTC_FORMAT_BIN);
	if(RtcTime.Seconds != compareSeconds) {
		printf("Date: %02d.%02d.20%02d Time: %02d:%02d:%02d\r\n", RtcDate.Date, RtcDate.Month, RtcDate.Year, RtcTime.Hours, RtcTime.Minutes, RtcTime.Seconds);
		compareSeconds = RtcTime.Seconds;
	}

    osDelay(20);
  }
  /* USER CODE END StartIoTask */
}

/**
  * @brief  Period elapsed callback in non blocking mode
  * @note   This function is called  when TIM1 interrupt took place, inside
  * HAL_TIM_IRQHandler(). It makes a direct call to HAL_IncTick() to increment
  * a global variable "uwTick" used as application time base.
  * @param  htim : TIM handle
  * @retval None
  */
void HAL_TIM_PeriodElapsedCallback(TIM_HandleTypeDef *htim)
{
  if (htim->Instance == TIM1) {
    HAL_IncTick();
  }
}

/**
  * @brief  This function is executed in case of error occurrence.
  * @retval None
  */
void Error_Handler(void)
{
  /* USER CODE BEGIN Error_Handler_Debug */
  /* User can add his own implementation to report the HAL error return state */
  __disable_irq();
  while (1)
  {
  }
  /* USER CODE END Error_Handler_Debug */
}

#ifdef  USE_FULL_ASSERT
/**
  * @brief  Reports the name of the source file and the source line number
  *         where the assert_param error has occurred.
  * @param  file: pointer to the source file name
  * @param  line: assert_param error line source number
  * @retval None
  */
void assert_failed(uint8_t *file, uint32_t line)
{
  /* USER CODE BEGIN 6 */
  /* User can add his own implementation to report the file name and line number,
     ex: printf("Wrong parameters value: file %s on line %d\r\n", file, line) */
  /* USER CODE END 6 */
}
#endif /* USE_FULL_ASSERT */
