marekw1986/InternetRadioSTM32/code/Core/Inc/main.h

#define VS_XRST_Pin GPIO_PIN_13
#define VS_XRST_GPIO_Port GPIOC
#define USB_EN_Pin GPIO_PIN_0
#define USB_EN_GPIO_Port GPIOC
#define USB_OVERCURRENT_Pin GPIO_PIN_5
#define USB_OVERCURRENT_GPIO_Port GPIOA
#define TST_Pin GPIO_PIN_10
#define TST_GPIO_Port GPIOB
#define NEXT_BTN_Pin GPIO_PIN_14
#define NEXT_BTN_GPIO_Port GPIOB
#define SPIRAM_CS_Pin GPIO_PIN_15
#define SPIRAM_CS_GPIO_Port GPIOA
#define SD_PRESENT_Pin GPIO_PIN_2
#define SD_PRESENT_GPIO_Port GPIOD
#define VS_XDCS_Pin GPIO_PIN_6
#define VS_XDCS_GPIO_Port GPIOB
#define VS_XCS_Pin GPIO_PIN_7
#define VS_XCS_GPIO_Port GPIOB
#define VS_DREQ_Pin GPIO_PIN_8
#define VS_DREQ_GPIO_Port GPIOB
#define SD_CS_Pin GPIO_PIN_9
#define SD_CS_GPIO_Port GPIOB
#define SD_SPI_HANDLE hspi3
