marekw1986/InternetRadioSTM32/code/Core/Src/spiram.c

/*
 * spiram.c
 *
 *  Created on: 4 kwi 2021
 *      Author: marek
 */

#include <stdlib.h>
#include <stdint.h>
#include <stdio.h>
#include <tm.h>
#include "stm32f1xx_hal.h"
#include "main.h"
#include "spiram.h"

#define RDMR        5       // Read the Mode Register
#define WRMR        1       // Write to the Mode Register
#define READ        3       // Read command
#define WRITE       2       // Write command
#define RSTIO     	0xFF    // Reset memory to SPI mode
#define BYTE_MODE   0x00    // Byte mode (read/write one byte at a time)
#define SEQ_MODE 	0x40    // Sequential mode (read/write blocks of memory)

#define enableRAM()		HAL_GPIO_WritePin(SPIRAM_CS_GPIO_Port, SPIRAM_CS_Pin, 0)
#define disableRAM()	HAL_GPIO_WritePin(SPIRAM_CS_GPIO_Port, SPIRAM_CS_Pin, 1)

extern SPI_HandleTypeDef hspi3;

static uint32_t spiram_ringbuffer_head = 0;
static uint32_t spiram_ringbuffer_tail = 0;

void spiram_init(void) {
    // 6. increase speed
    if (HAL_SPI_DeInit(&hspi3) != HAL_OK) {
    	printf("SPIRAM: SPI3 deinit error\r\n");
    }
	hspi3.Init.BaudRatePrescaler = SPI_BAUDRATEPRESCALER_2;
    if (HAL_SPI_Init(&hspi3) != HAL_OK) {
    	printf("SPIRAM: SPI3 init error\r\n");
    }
}

static void spiram_setmode(uint8_t mode ) {
	uint8_t tmp[2] = {WRMR, mode};

	enableRAM();
	HAL_SPI_Transmit(&hspi3, tmp, 2, HAL_MAX_DELAY);
	disableRAM();
}


void spiram_clear(void) {
	uint8_t tmp[4] = {WRITE, 0x00, 0x00, 0x00};
	int i;

	spiram_ringbuffer_head = 0;
	spiram_ringbuffer_tail = 0;
	spiram_setmode(SEQ_MODE);

	enableRAM();
	HAL_SPI_Transmit(&hspi3, tmp, 4, HAL_MAX_DELAY);
	for (i=0; i<0x20000; i++) {
		HAL_SPI_Transmit(&hspi3, &tmp[1], 1, HAL_MAX_DELAY);
	}
	disableRAM();
}


void spiram_writebyte(uint32_t address, uint8_t data) {
	uint8_t tmp[4] = {WRITE, (uint8_t)(address >> 16), (uint8_t)(address >> 8), (uint8_t)address};

	spiram_setmode(BYTE_MODE);

	enableRAM();
	HAL_SPI_Transmit(&hspi3, tmp, 4, HAL_MAX_DELAY);
	HAL_SPI_Transmit(&hspi3, &data, 1, HAL_MAX_DELAY);
	disableRAM();
}


uint8_t spiram_readbyte(uint32_t address) {
	uint8_t tmp[4] = {READ, (uint8_t)(address >> 16), (uint8_t)(address >> 8), (uint8_t)address};

	spiram_setmode(BYTE_MODE);

	enableRAM();
	HAL_SPI_Transmit(&hspi3, tmp, 4, HAL_MAX_DELAY);
	HAL_SPI_Receive(&hspi3, &tmp[0], 1, HAL_MAX_DELAY);
	disableRAM();

	return tmp[0];
}


void spiram_writearray(uint32_t address, uint8_t *data, uint16_t len) {
	uint8_t tmp[4] = {WRITE, (uint8_t)(address >> 16), (uint8_t)(address >> 8), (uint8_t)address};

	spiram_setmode(SEQ_MODE);

	enableRAM();
	HAL_SPI_Transmit(&hspi3, tmp, 4, HAL_MAX_DELAY);
	HAL_SPI_Transmit(&hspi3, data, len, HAL_MAX_DELAY);
	disableRAM();
}


void spiram_readarray(uint32_t address, uint8_t *data, uint16_t len) {
	uint8_t tmp[4] = {READ, (uint8_t)(address >> 16), (uint8_t)(address >> 8), (uint8_t)address};

	spiram_setmode(SEQ_MODE);

	enableRAM();
	HAL_SPI_Transmit(&hspi3, tmp, 4, HAL_MAX_DELAY);
	HAL_SPI_Receive(&hspi3, data, len, HAL_MAX_DELAY);
	disableRAM();
}


void spiram_write_array_to_ringbuffer(uint8_t* data, uint16_t len) {
	uint8_t tmp[4] = {WRITE, (uint8_t)(spiram_ringbuffer_head >> 16), (uint8_t)(spiram_ringbuffer_head >> 8), (uint8_t)spiram_ringbuffer_head};

	//printf("Writing to ring buffer, head: %lu, tail: %lu\r\n", spiram_ringbuffer_head, spiram_ringbuffer_tail);

	spiram_setmode(SEQ_MODE);
	enableRAM();
	HAL_SPI_Transmit(&hspi3, tmp, 4, HAL_MAX_DELAY);
	for (int i=0; i<len; i++) {
		HAL_SPI_Transmit(&hspi3, &data[i], 1, HAL_MAX_DELAY);
		spiram_ringbuffer_head++;
		if (spiram_ringbuffer_head >= 0x20000) {
			spiram_ringbuffer_head = 0;
			disableRAM();
			//delay?
			//delay_us(20);
			tmp[0] = WRITE;
			tmp[1] = 0x00;
			tmp[2] = 0x00;
			tmp[3] = 0x00;
			spiram_setmode(SEQ_MODE);
			enableRAM();
			HAL_SPI_Transmit(&hspi3, tmp, 4, HAL_MAX_DELAY);
		}
		//If no space in buffer, it will simply override
	}
	disableRAM();
}

uint32_t spiram_read_array_from_ringbuffer(uint8_t* data, uint32_t len) {
	uint8_t tmp[4] = {READ, (uint8_t)(spiram_ringbuffer_tail >> 16), (uint8_t)(spiram_ringbuffer_tail >> 8), (uint8_t)spiram_ringbuffer_tail};
	uint32_t bytes_read = 0;

	if (spiram_ringbuffer_head == spiram_ringbuffer_tail) return 0;

	//printf("Reading from ring buffer, head: %lu, tail: %lu\r\n", spiram_ringbuffer_head, spiram_ringbuffer_tail);

	enableRAM();
	HAL_SPI_Transmit(&hspi3, tmp, 4, HAL_MAX_DELAY);
	for(int i=0; i<len; i++) {
		HAL_SPI_Receive(&hspi3, &data[i], 1, HAL_MAX_DELAY);
		spiram_ringbuffer_tail++;
		bytes_read++;
		if (spiram_ringbuffer_tail >= 0x20000) {
			spiram_ringbuffer_tail = 0;
			disableRAM();
			//delay?
			//delay_us(20);
			tmp[0] = READ;
			tmp[1] = 0x00;
			tmp[2] = 0x00;
			tmp[3] = 0x00;
			spiram_setmode(SEQ_MODE);
			enableRAM();
			HAL_SPI_Transmit(&hspi3, tmp, 4, HAL_MAX_DELAY);
		}
		if (spiram_ringbuffer_tail == spiram_ringbuffer_head) {
			break;
		}
	}
	disableRAM();

	return bytes_read;
}

void spiram_clear_ringbuffer(void) {
	spiram_ringbuffer_head = 0;
	spiram_ringbuffer_tail = 0;
}

uint32_t spiram_get_remaining_space_in_ringbuffer() {
	return (spiram_ringbuffer_tail > spiram_ringbuffer_head) ? spiram_ringbuffer_tail-spiram_ringbuffer_head : 0x20000 - spiram_ringbuffer_head + spiram_ringbuffer_tail;
}

uint16_t spiram_get_num_of_bytes_in_ringbuffer() {
    return 0x20000 - spiram_get_remaining_space_in_ringbuffer();
}
