marekw1986/InternetRadioSTM32/(commit log)

2020-12-25 minor changes
    [main_board.brd, main_board.sch]
2020-12-26 UART3 TX trace added
    [main_board.brd, main_board.sch]
2020-12-27 USB overcurrent protection added
    [main_board.brd, main_board.sch]
2020-12-27 Schematic updated
    [main_board.brd, main_board.sch]
2020-12-28 Ethernet AVDD filtering
    [main_board.brd, main_board.sch]
2021-04-04 SPI RAM
2022-09-27 Ring buffer in SPI RAM (in progress)
2022-09-29 SPI ring buffer used for SD playback
2022-10-08 SPI speed increased
2022-10-08 TODO.md added, VS1003 SPI speed increased
2022-10-08 Circular buffr moved back to SPI RAM
2022-10-09 Buttons library added + several small fixes
    [InternetRadio.ioc, buttons.c, buttons.h, main.c, main.h, vs1003.c]
2022-10-19 Problem with choppy playback fixed
    [vs1003.c]
2022-10-27 Implementing Socket API (in progress)
2022-10-28 Implementing socket API in VS1003 state machine (in progress)
2022-11-01 Additional printfs
2022-11-02 SPIRAM/SD SPI (3) made slower for increased stability
    [main.c, spiram.c]
2022-11-03 Buttons integrated with FreeRTOS
