marekw1986/InternetRadioSTM32/(notices)

Notices in the files:
code/Core/Src/main.c:
© Copyright (c) 2021 STMicroelectronics.
All rights reserved.
This software component is licensed by ST under Ultimate Liberty license
parts and their libraries:
SparkFun-Aesthetics: Licensing: Creative Commons ShareAlike 4.0 International - https://creativecommons.org/licenses/by-sa/4.0
FaBo-Supply: Released under the Creative Commons Attribution-ShareAlike 4.0 License
https://creativecommons.org/licenses/by-sa/4.0
